PicoNodes/PicoNodes/pcb/motherboard/voltage regulation.org

Assuming LM317 regulator
target Vo: 3.3V
from datasheet: Vo = 1.25 * (1 + r / 240)

Where Vo = 3.3: r = 393.6 (~= 390Ω)

regulator:
https://www.kjell.com/se/sortiment/el-verktyg/elektronik/halvledare/spanningsregulatorer/luxorparts-spanningsregulator-variabel-lm317-5-pack-p90491
30kr for 5x

heat sink:
https://www.kjell.com/se/sortiment/el-verktyg/elektronik/elektromekanik/kylelement-peltier/luxorparts-kylflans-to-220-10-pack-p90668
40kr for 10x
