PicoNodes/PicoNodes/docs/architecture.docx

ää

Crystal

- Userinterface via browser(hemsida)
- Programmeringsinterface?
- Programmerare för MCU
- WiFi-kommunikation med server
- UARTx2
- Avkodare(FDTI)
- Kompilator
- Drivrutiner

WiFi

WiFi

Access Point(Plattform med WiFi)

Mobil Station(laptop, mobiltelefon)

Server

MOD

OD

MOD

MOD

MOD

MOD

MOD
