PicoNodes/PicoNodes/docs/server-diagram.jpg

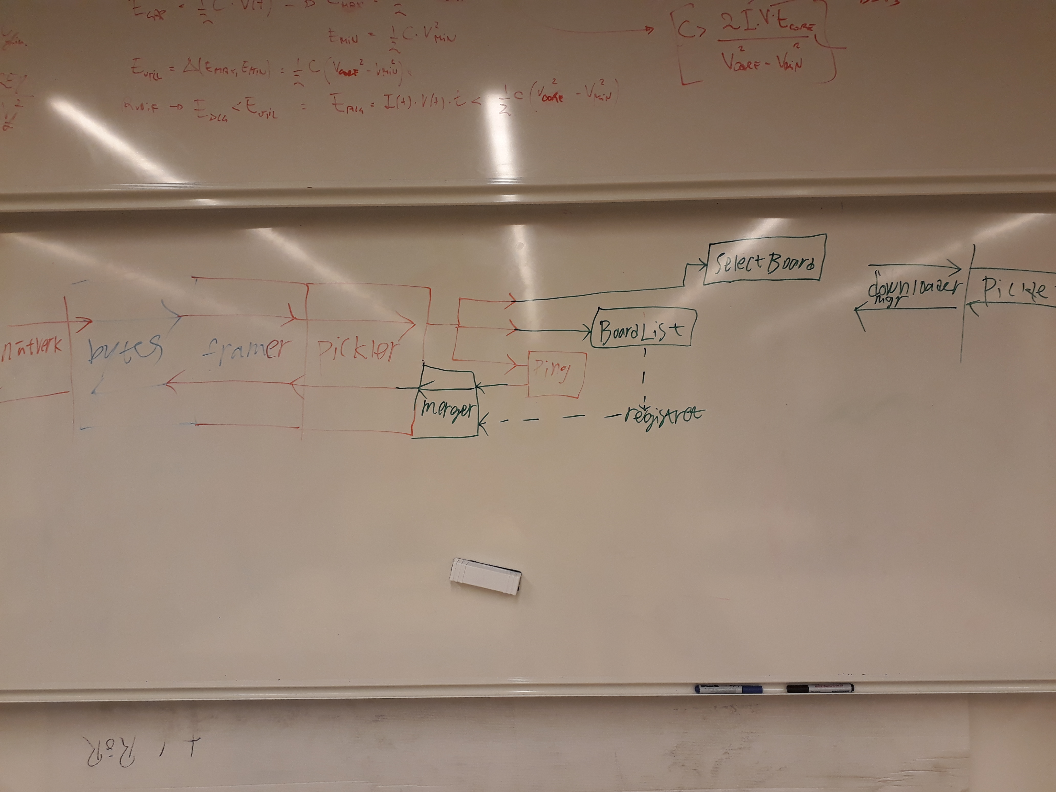
docs/server-diagram.jpg
