PicoNodes/PicoNodes/pcb/digit-node-breakout/digit-node.stl

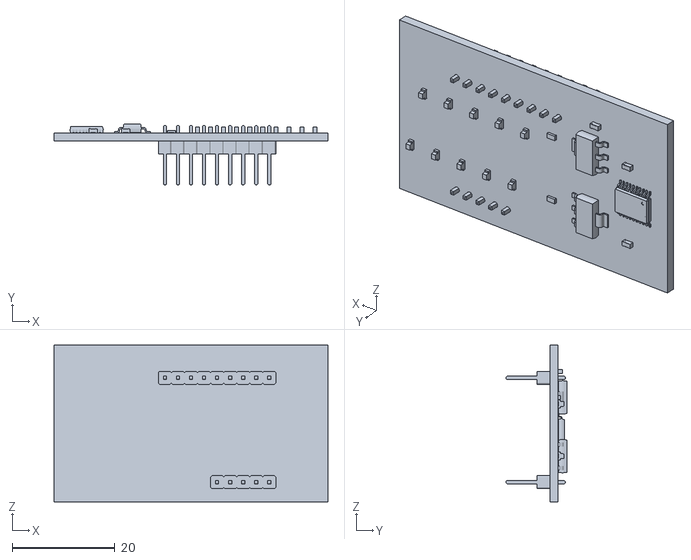
[picture p8: CAD file, 2018-05-01]
pcb/digit-node-breakout/digit-node.stl
53.3 x 11.8 x 30.5
