PicoNodes/PicoNodes/(threads)

Thread 9 (2018-03-21):

Design compute node PCB

Thereseken, 2018-03-21:

teozkr, 2018-04-19:
This was tracking the "production" PCBs, for use with the motherboard. The breakout board PCB was tracked by #18.

Closed 2018-05-08.

Thread 12 (2018-03-28):

Messy autoformatting - move to diffing?

teozkr, 2018-03-28:
Currently autoformatting tries to guess when you're "done" editing a line, and then replaces only that line. This is needed since CodeMirror moves the cursor to the end of the modified segment, if it was inside it.

It would be much nicer if we diffed the replacements, so that only the actually modified segments have to be moved around.

Alternately, consider moving to true [projectional editing]?

[projectional editing]: https://en.wikipedia.org/wiki/Structure_editor

Thread 15 (2018-03-30):

Clear up terminology

teozkr, 2018-03-30:
Currently we don't really have clear names for the different parts of the system. For example, so far I've referred to anything with a MCU in it as a "node", making the term fairly useless.

Therefore, I propose the following names:

* IDE: The graphical editor and debugger, code in `ide/picoide`
* Server: Serves the IDE, stores all data, and controls the Downloaders, code in `ide/picoserver`
* Downloader: Combined debugger and programmer, controls a single Node at a time
* Motherboard: Connects all the Nodes to each other, and supplies power and a common clock
* Node: Any component that is part of the target system, aside from the Motherboard
* NodePlug:tm:: The connector between a Node and the Motherboard
* Compute Node: A programmable Node running user-supplied code
* PicoASM: The language Compute Nodes are programmed in
* Peripheral Node: Any Node that is not a Compute Node
* PicoTalk: The protocol for communication between Nodes

# Why `Downloader`?

So far we've called these Programmers or Programmer Nodes, but both of these are confusing. As Mark mentioned, calling them `Programmer`s cheapens the act of /programming/ (which is what the users will be doing the rest of the time). They're also not Nodes, since they don't use the NodePlug, and don't use the Node<->Node protocol.

Other options:

* Controller
* Debugger

teozkr, 2018-04-10:
Moving this to `docs` since we agreed on it.

Closed 2018-04-10.

Thread 27 (2018-04-23):

Heartbeat for downloader<->server

teozkr, 2018-04-23:

teozkr, 2018-04-23:
This will require some refactoring, since the downloaders currently don't understand PicoStorm at all. We could either let it buffer messages completely, or just maintain bookkeeping to avoid injecting heartbeats in the middle of messages. Hmm...

Closed 2018-04-23.

Thread 33 (2018-04-30):

Numeric display

teozkr, 2018-04-30:

teozkr, 2018-04-30:
Working on a custom [Lixie](https://www.tindie.com/products/connornishijima/lixie-an-led-alternative-to-the-nixie-tube/) clone for this. It'll (sadly) have to be a single-digit display in order to fit into the Node form factor.

Thread 38 (2018-05-16):

ESP32 brownouts when 2 or more nodes are connected

teozkr, 2018-05-16:

teozkr, 2018-05-16:
Looks like we'll need our own voltage regulation circuitry.

The STM32F030F4 parts (and thus the nodes) can draw up to 120mA each:

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

The ESP requires a power supply capable of at least 500mA:

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

So in total we need a power supply capable of at least `500 + 9 * 120 = 1580` mA@3.3V.

The USB spec allows drawing up to 1.5A@5V, but only when negotiating via the Battery Charging spec or when using USB-C cables.

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

So I guess it looks like the most reasonable option is to switch to a barrel PSU... :/
