PicoNodes/PicoNodes/(list of files, drawings)

Other design files:
pcb/compute-node-breakout/more_flash_mod.dch
pcb/compute-node-breakout/more_flash_mod.dip
pcb/compute-node-breakout/proj_mod.dch
pcb/compute-node-breakout/test_mod.dip
