PicoNodes/PicoNodes/pcb/led-node/led-node.kicad_pcb

## KiCad design pcb/led-node/led-node.kicad_pcb (2018-05-29)

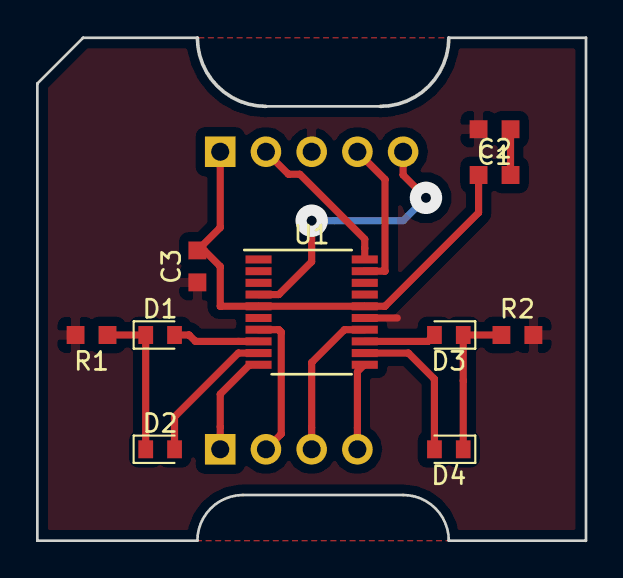
[picture p9: board led-node.kicad_pcb from above]

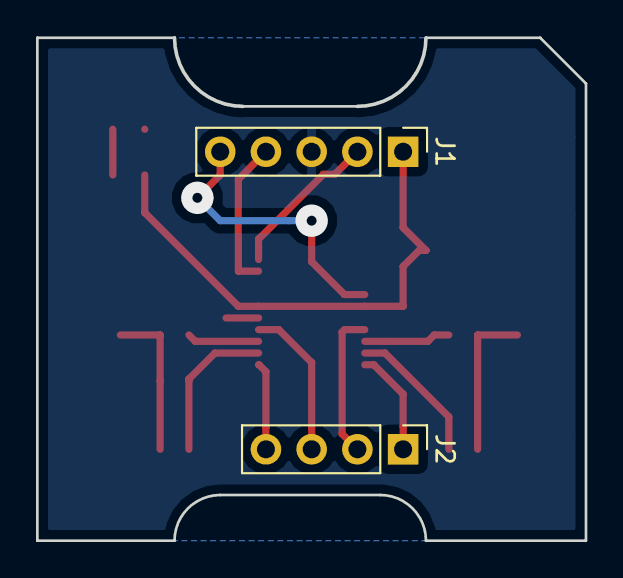
[picture p10: board led-node.kicad_pcb from below]

Board: 2 copper layers, 30.5 x 27.9 mm, 12 parts (2 on the bottom side), 16 nets.

Parts:
C1, C2: 100nF; C_0603_1608Metric_Pad0.99x1.00mm_HandSolder
C3: 10nF; C_0603_1608Metric_Pad0.99x1.00mm_HandSolder
D1: LED1; LED_0603_1608Metric_Pad0.82x1.00mm_HandSolder
D2: LED2; LED_0603_1608Metric_Pad0.82x1.00mm_HandSolder
D3: LED3; LED_0603_1608Metric_Pad0.82x1.00mm_HandSolder
D4: LED4; LED_0603_1608Metric_Pad0.82x1.00mm_HandSolder
J1: STM32_SWD; PinHeader_1x05_P2.54mm_Vertical
J2: PicoTalk; PinHeader_1x04_P2.54mm_Vertical
R1, R2: 100; R_0603_1608Metric_Pad0.99x1.00mm_HandSolder
U1: STM32F030F4Px; TSSOP-20_4.4x6.5mm_P0.65mm

Connections:
/Down: J2.1, U1.10
/Left: J2.2, U1.7
/Right: J2.4, U1.11
/SWCLK: J1.2, U1.20
/SWDIO: J1.4, U1.19
/Up: J2.3, U1.14
/nRST: J1.5, U1.4
GND: C1.2, C3.1, J1.3, R1.2, R2.2, U1.15
unnamed: C1.1, C2.2
unnamed: D1.1, D2.1, R1.1
unnamed: D1.2, U1.8
unnamed: D2.2, U1.9
unnamed: D3.1, D4.1, R2.1
unnamed: D3.2, U1.13
unnamed: D4.2, U1.12
VDD: C2.1, C3.2, J1.1, U1.5, U1.16
