PicoNodes/PicoNodes/pcb/motherboard/motherboard.kicad_pcb

## KiCad design pcb/motherboard/motherboard.kicad_pcb (2018-05-22)

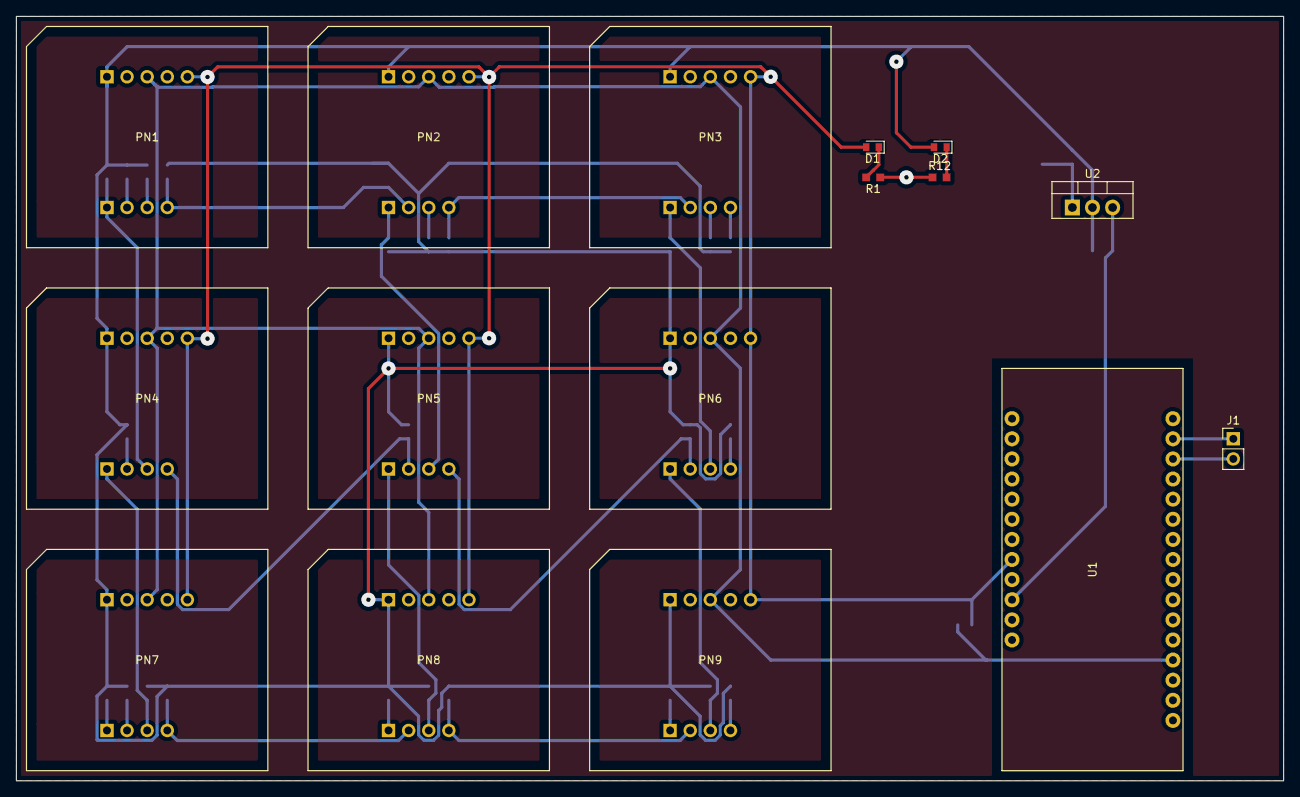
[picture p11: board motherboard.kicad_pcb from above]

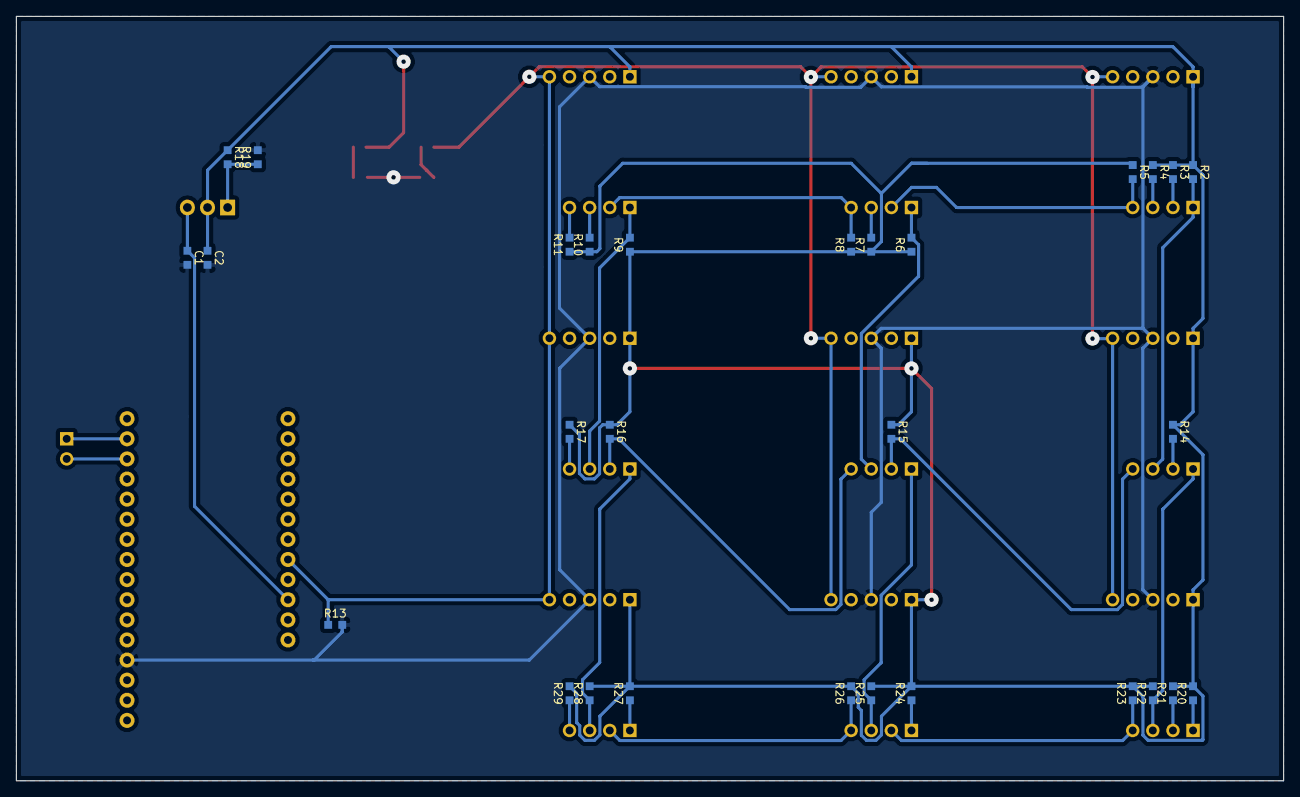
[picture p12: board motherboard.kicad_pcb from below]

Board: 2 copper layers, 160.0 x 96.5 mm, 45 parts (29 on the bottom side), 33 nets.

Parts:
C1: 0.1µF; C_0603_1608Metric_Pad0.99x1.00mm_HandSolder
C2: 1.0µF; C_0603_1608Metric_Pad0.99x1.00mm_HandSolder
D1: LED_Reset; LED_0603_1608Metric_Pad0.82x1.00mm_HandSolder
D2: LED_Vdd; LED_0603_1608Metric_Pad0.82x1.00mm_HandSolder
J1: UART; PinHeader_1x02_P2.54mm_Vertical
PN1, PN2, PN3, PN4, PN5, PN6, PN7, PN8, PN9: PicoNode-Socket-PH
R1, R12: 100; R_0603_1608Metric_Pad0.99x1.00mm_HandSolder
R2, R3, R4, R5, R6, R7, R8, R9, R10, R11, R14, R15, R16, R17, R20, R21, R22, R23, R24, R25, R26, R27, R28, R29: 4.7K; R_0603_1608Metric_Pad0.99x1.00mm_HandSolder
R13: 820; R_0603_1608Metric_Pad0.99x1.00mm_HandSolder
R18: 240; R_0603_1608Metric_Pad0.99x1.00mm_HandSolder
R19: 390; R_0603_1608Metric_Pad0.99x1.00mm_HandSolder
U1: Huzzah32; Adafruit_HUZZAH32
U2: LM317_3PinPackage; TO-220-3_Vertical

Connections:
/RX: J1.2, U1.26
/TX: J1.1, U1.27
/nReset: D1.2, PN1.5, PN2.5, PN3.5, PN4.5, PN5.5, PN6.5, PN7.5, PN8.5, PN9.5, R13.1, U1.5
GND: C1.2, C2.2, PN1.3, PN2.3, PN3.3, PN4.3, PN5.3, PN6.3, PN7.3, PN8.3, PN9.3, R1.1, R12.1, R13.2, R19.2, U1.16
unnamed: D1.1, R1.2
unnamed: D2.1, R12.2
unnamed: PN1.6, PN4.8, R2.2
unnamed: PN1.7, R3.2
unnamed: PN1.8, R4.2
unnamed: PN1.9, PN2.7, R5.2
unnamed: PN2.6, PN5.8, R6.2
unnamed: PN2.8, R7.2
unnamed: PN2.9, PN3.7, R8.2
unnamed: PN3.6, PN6.8, R9.2
unnamed: PN3.8, R10.2
unnamed: PN3.9, R11.2
unnamed: PN4.6, PN7.8, R22.1
unnamed: PN4.7, R14.2
unnamed: PN4.9, PN5.7, R15.2
unnamed: PN5.6, PN8.8, R25.1
unnamed: PN5.9, PN6.7, R16.2
unnamed: PN6.6, PN9.8, R28.1
unnamed: PN6.9, R17.2
unnamed: PN7.6, R20.1
unnamed: PN7.7, R21.1
unnamed: PN7.9, PN8.7, R23.1
unnamed: PN8.6, R24.1
unnamed: PN8.9, PN9.7, R26.1
unnamed: PN9.6, R27.1
unnamed: PN9.9, R29.1
unnamed: R18.2, R19.1, U2.1
VBUS: C1.1, U1.3, U2.3
VDD: C2.1, D2.2, PN1.1, PN2.1, PN3.1, PN4.1, PN5.1, PN6.1, PN7.1, PN8.1, PN9.1, R2.1, R3.1, R4.1, R5.1, R6.1, R7.1, R8.1, R9.1, R10.1, R11.1, R14.1, R15.1, R16.1, R17.1, R18.1, R20.2, R21.2, R22.2, R23.2, R24.2, R25.2, R26.2, R27.2, R28.2, R29.2, U2.2
