PicoNodes/PicoNodes/pcb/voltage-regulator-mezzanine/voltage-regulator-mezzanine.kicad_pcb

## KiCad design pcb/voltage-regulator-mezzanine/voltage-regulator-mezzanine.kicad_pcb (2018-05-19)

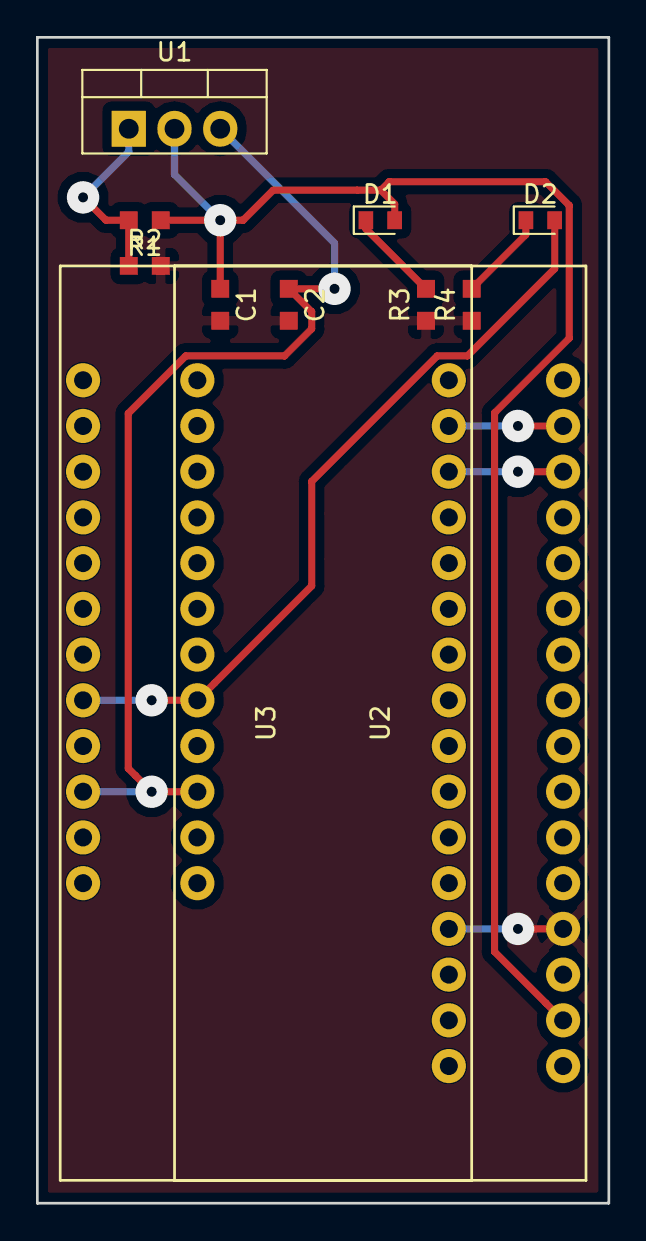
[picture p13: board voltage-regulator-mezzanine.kicad_pcb from above]

Board: 2 copper layers, 31.8 x 64.8 mm, 11 parts (0 on the bottom side), 9 nets.

Parts:
C1: 1.0µF; C_0603_1608Metric_Pad0.99x1.00mm_HandSolder
C2: 0.1µF; C_0603_1608Metric_Pad0.99x1.00mm_HandSolder
D1: LED_vdd; LED_0603_1608Metric_Pad0.82x1.00mm_HandSolder
D2: LED_nReset; LED_0603_1608Metric_Pad0.82x1.00mm_HandSolder
R1: 240; R_0603_1608Metric_Pad0.99x1.00mm_HandSolder
R2: 390; R_0603_1608Metric_Pad0.99x1.00mm_HandSolder
R3, R4: 100; R_0603_1608Metric_Pad0.99x1.00mm_HandSolder
U1: LM317_3PinPackage; TO-220-3_Vertical
U2: Huzzah32_fake; Adafruit_HUZZAH32
U3: Huzzah32_real; Adafruit_HUZZAH32

Connections:
/Adj: R1.2, R2.1, U1.1
GND: C1.2, C2.2, R2.2, R3.1, R4.1, U2.16, U3.16
unnamed: D1.1, R3.2
unnamed: D2.1, R4.2
unnamed: D2.2, U2.5, U3.5
unnamed: U2.26, U3.26
unnamed: U2.27, U3.27
VBUS: C2.1, U1.3, U2.3, U3.3
VDD: C1.1, D1.2, R1.1, U1.2, U2.14
