PicoNodes/PicoNodes/pcb/debug-mezzanine/debug-mezzanine.kicad_pcb

## KiCad design pcb/debug-mezzanine/debug-mezzanine.kicad_pcb (2018-05-15)

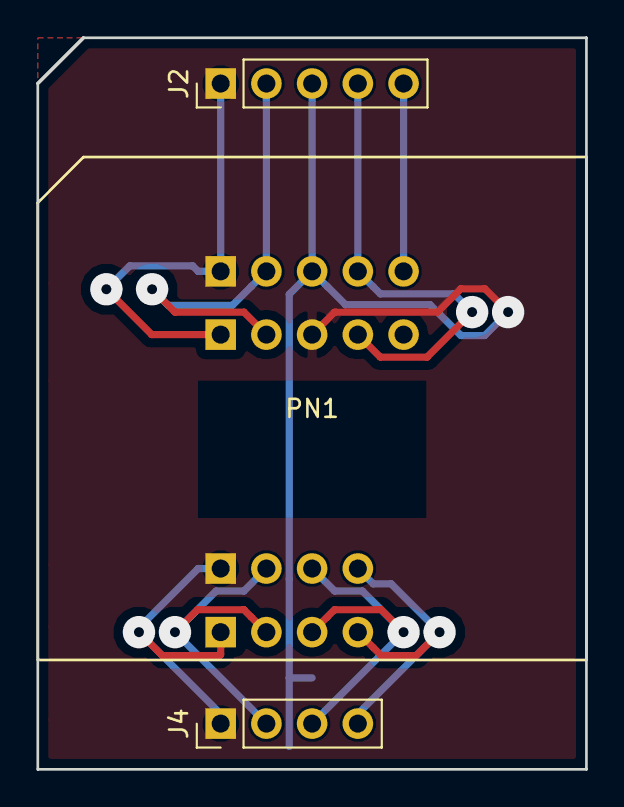
[picture p14: board debug-mezzanine.kicad_pcb from above]

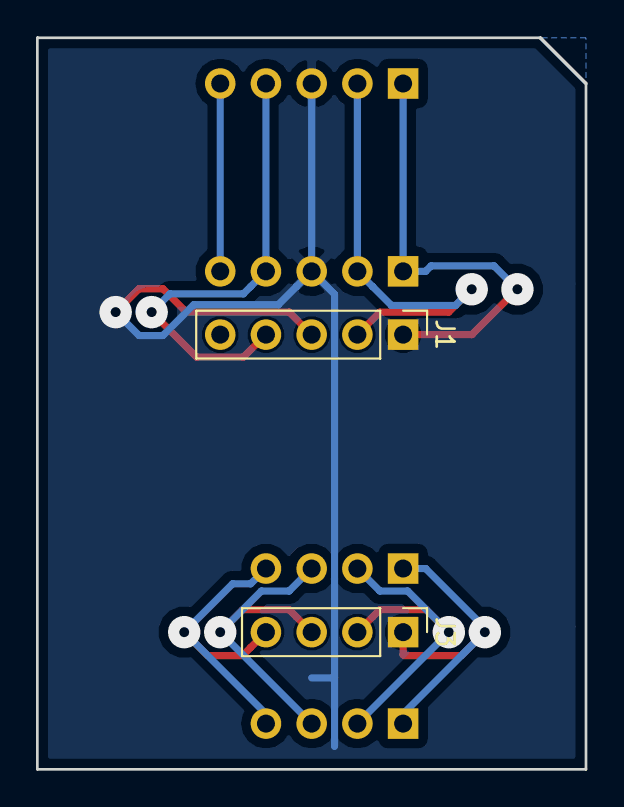
[picture p15: board debug-mezzanine.kicad_pcb from below]

Board: 2 copper layers, 30.5 x 40.6 mm, 5 parts (2 on the bottom side), 9 nets.

Parts:
J1, J2: STM32_SWD; PinHeader_1x05_P2.54mm_Vertical
J3, J4: PicoTalk; PinHeader_1x04_P2.54mm_Vertical
PN1: PicoNode-Socket-PH

Connections:
GND: J1.3, J2.3, PN1.3
unnamed: J1.2, J2.2, PN1.2
unnamed: J1.4, J2.4, PN1.4
unnamed: J2.5, PN1.5
unnamed: J3.1, J4.1, PN1.6
unnamed: J3.2, J4.2, PN1.7
unnamed: J3.3, J4.3, PN1.8
unnamed: J3.4, J4.4, PN1.9
VDD: J1.1, J2.1, PN1.1
