PicoNodes/PicoNodes/pcb/digit-node-breakout/digit-node.kicad_pcb

## KiCad design pcb/digit-node-breakout/digit-node.kicad_pcb (2018-05-03)

Schematic: digit-node.sch

Parts:
C1, C2, C3: CP; C_0603_1608Metric
J1: Conn_01x09_Male; PinHeader_1x09_P2.54mm_Vertical
J2: STM32_SWD; PinHeader_1x05_P2.54mm_Vertical
Q1: BC847BS; SOT-363_SC-70-6
R1, R2: 100; R_0603_1608Metric
U1: STM32F030F4Px; TSSOP-20_4.4x6.5mm_P0.65mm

Connections:
/led_matrix/gnd_even: R2.1; also elsewhere on the board
/led_matrix/gnd_odd: R1.1; also elsewhere on the board
/led_matrix/led_01: U1.14; also elsewhere on the board
/led_matrix/led_23: U1.8; also elsewhere on the board
/led_matrix/led_45: U1.9; also elsewhere on the board
/led_matrix/led_67: U1.12; also elsewhere on the board
/led_matrix/led_89: U1.13; also elsewhere on the board
GND: C1.2, C3.2, J1.1, J2.3, Q1.1 (E1), Q1.4 (E2), U1.15
unnamed: C2.2, C3.1
unnamed: J1.4, U1.6
unnamed: J1.5, U1.3
unnamed: J1.6, U1.2
unnamed: J1.7, U1.7
unnamed: J1.8, U1.17
unnamed: J1.9, U1.18
unnamed: J2.2, U1.20
unnamed: J2.4, U1.19
unnamed: J2.5, U1.4
unnamed: Q1.2 (B1), U1.10
unnamed: Q1.3 (C2), R2.2
unnamed: Q1.5 (B2), U1.11
unnamed: Q1.6 (C1), R1.2
VDD: C1.1, J1.2, J2.1, U1.16
VDDA: C2.1, J1.3, U1.5

Schematic: led_matrix.sch

Parts:
D1: LED_0; LED_0603_1608Metric
D2: LED_1; LED_0603_1608Metric
D3: LED_2; LED_0603_1608Metric
D4: LED_3; LED_0603_1608Metric
D5: LED_4; LED_0603_1608Metric
D6: LED_5; LED_0603_1608Metric
D7: LED_6; LED_0603_1608Metric
D8: LED_7; LED_0603_1608Metric
D9: LED_8; LED_0603_1608Metric
D10: LED_9; LED_0603_1608Metric

Connections:
/led_matrix/gnd_even: D2.1, D4.1, D6.1, D8.1, D10.1; also elsewhere on the board
/led_matrix/gnd_odd: D1.1, D3.1, D5.1, D7.1, D9.1; also elsewhere on the board
/led_matrix/led_01: D1.2, D2.2; also elsewhere on the board
/led_matrix/led_23: D3.2, D4.2; also elsewhere on the board
/led_matrix/led_45: D5.2, D6.2; also elsewhere on the board
/led_matrix/led_67: D7.2, D8.2; also elsewhere on the board
/led_matrix/led_89: D9.2, D10.2; also elsewhere on the board

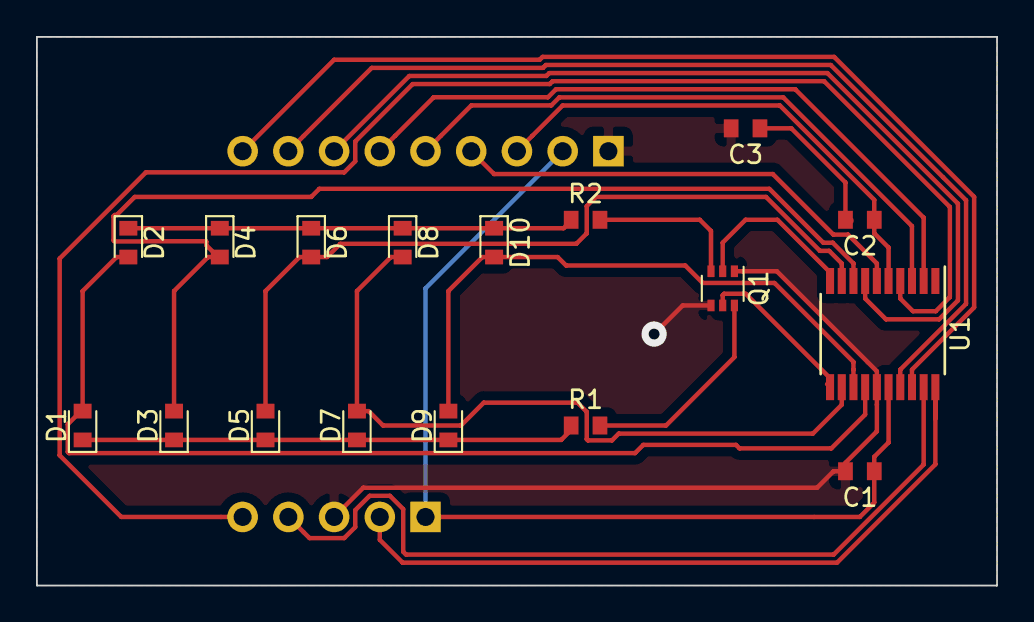
[picture p16: board digit-node.kicad_pcb from above]

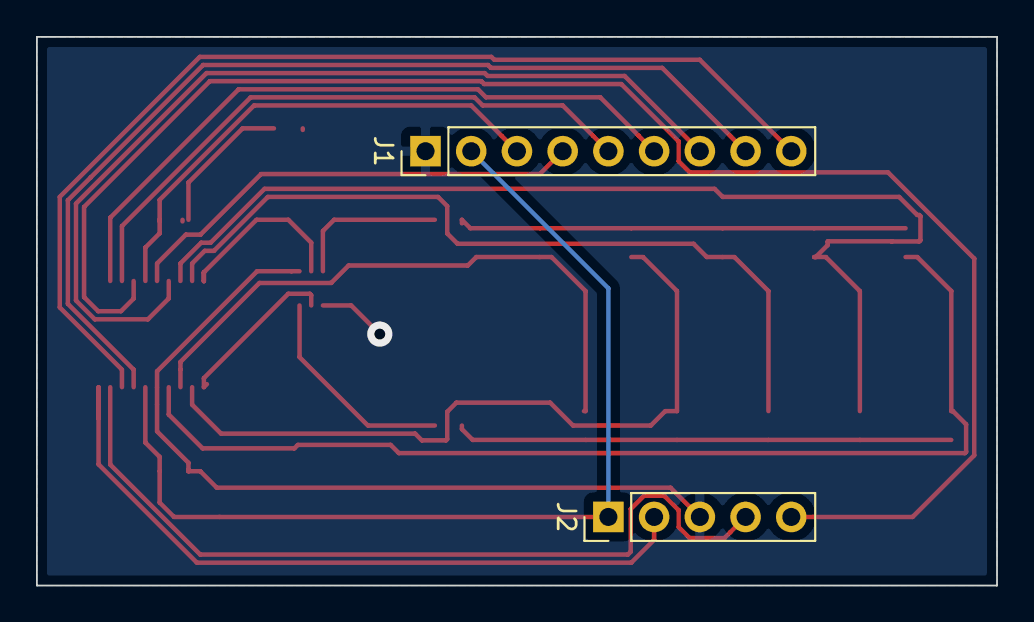
[picture p17: board digit-node.kicad_pcb from below]

Board: 2 copper layers, 53.3 x 30.5 mm, 19 parts (2 on the bottom side), 24 nets.
