PicoNodes/PicoNodes/firmware/node-compute/opendrainy-rtfm/src/main.rs

// -*- mode: rust; flycheck-rust-check-tests: nil; -*-

#![feature(used, proc_macro)]
#![no_std]

extern crate cortex_m;
extern crate cortex_m_rt;
extern crate cortex_m_rtfm as rtfm;
extern crate cortex_m_semihosting;
extern crate panic_semihosting;
extern crate stm32f0x0_hal;
extern crate embedded_hal;
extern crate picostorm;

#[macro_use]
extern crate nb;

use core::fmt::Write;
use cortex_m_semihosting::hio;

use rtfm::{app, Threshold};
#[allow(unused)]
use cortex_m::asm;

use stm32f0x0_hal::prelude::*;
use stm32f0x0_hal::stm32f0x0;
use stm32f0x0_hal::serial::{Rx, Tx, Serial, Event as SerialEvent};
use stm32f0x0_hal::gpio::{Output, OpenDrain, gpioa::PA4};
use stm32f0x0_hal::timer::{Timer, Event as TimerEvent};

fn echo_incoming(_t: &mut Threshold, r: USART1::Resources) {
    let mut rx = r.SERIAL1_RX;

    let cmd = picostorm::Command::read(&mut *rx).unwrap();

    let mut out = hio::hstdout().unwrap();
    writeln!(out, "{:?}", cmd).unwrap();
}

fn loopback(_t: &mut Threshold, r: USART1::Resources) {
    let mut rx = r.SERIAL1_RX;
    let mut tx = r.SERIAL1_TX;

    block!(tx.write(rx.read().unwrap())).unwrap();
}

fn blink(_t: &mut Threshold, r: TIM3::Resources) {
    let mut timer = r.BLINKY_TIMER;
    let mut state = r.BLINKY_STATE;
    let mut pin = r.BLINKY_PIN;

    timer.wait().unwrap();

    *state = !*state;
    if *state {
        pin.set_high();
    } else {
        pin.set_low();
    }
}

fn init(p: init::Peripherals, _r: init::Resources) -> init::LateResources {
    let mut rcc = p.device.RCC.constrain();
    let mut flash = p.device.FLASH.constrain();
    let clocks = rcc.cfgr.freeze(&mut flash.acr);
    let mut gpioa = p.device.GPIOA.split(&mut rcc.ahb);

    let pa2 = gpioa.pa2.into_af1(&mut gpioa.moder, &mut gpioa.afrl);
    let pa3 = gpioa.pa3.into_af1(&mut gpioa.moder, &mut gpioa.afrl);
    let pa4 = gpioa.pa4.into_open_drain_output(&mut gpioa.moder, &mut gpioa.otyper);

    let mut tim3 = Timer::tim3(p.device.TIM3, 1.hz(), clocks, &mut rcc.apb1);
    tim3.listen(TimerEvent::TimeOut);

    let usart1 = p.device.USART1;
    let mut serial = Serial::usart1(usart1, (pa2, pa3), 115_200.bps(), clocks, &mut rcc.apb2);
    serial.listen(SerialEvent::Rxne);
    let (tx, rx) = serial.split();

    init::LateResources {
        SERIAL1_RX: rx,
        SERIAL1_TX: tx,
        BLINKY_TIMER: tim3,
        BLINKY_PIN: pa4,
    }
}

fn idle() -> ! {
    loop {
        rtfm::wfi();
    }
}

app! {
    device: stm32f0x0,
    resources: {
        static SERIAL1_RX: Rx<stm32f0x0::USART1>;
        static SERIAL1_TX: Tx<stm32f0x0::USART1>;

        static BLINKY_TIMER: Timer<stm32f0x0::TIM3>;
        static BLINKY_STATE: bool = false;
        static BLINKY_PIN: PA4<Output<OpenDrain>>;
    },
    tasks: {
        USART1: {
            path: echo_incoming,
            resources: [SERIAL1_RX, SERIAL1_TX],
            priority: 2,
        },

        TIM3: {
            path: blink,
            resources: [BLINKY_TIMER, BLINKY_STATE, BLINKY_PIN],
            priority: 1,
        }
    }
}
