PicoNodes/PicoNodes/(commit log)

2018-03-20 Added design notes and PCB sketch
2018-03-20 Adding guide lines for external oscillator design and data sheet for the microcontroller STM32F030F4P6
    Adding guide lines for external oscillator design and data sheet for the microcontroller STM32F030F4P6
2018-03-20 First prototype of assembler
2018-03-20 Allow empty lines, comments prototype
2018-03-20 Module files
    PCB files for module, patterns and component
    [proj_mod.dch]
2018-03-21 greberfiler
    Alla gerberfiler som kan tänkas behövas för att fräsa PCB
    [proj_mod.dch, test_mod.dip]
2018-03-26 PCB and method in report
    beginning of method in the report
    [test_mod.dip]
2018-03-29 IDE: Started integrating IDEClient
    Currently broken because Sink.actorRefWithAck causes linking errors,
    investigating alternative solutions
2018-03-29 IDE: Board picker UI
2018-03-30 Connected board picker to NodeRegistry
2018-03-31 Client-side board selection
2018-04-04 module and project updates
    module and report updates
    [project_plan.xlsx]
2018-04-05 Swappable flow adapter
2018-04-05 Migrated to a separate IDECommandHandler stage
2018-04-05 More lenses
2018-04-11 testcodes and dic
    for mcu questionformular
    [test_mod.dip]
2018-04-11 LED blinker for F0 MCU
2018-04-11 Reorganized firmware to separate different parts
    Fixes #21
    [blinky.rs, main.rs]
2018-04-13 Moved stm32f0x0 to https://github.com/PicoNodes/stm32f0x0
2018-04-13 Renamed BoardPicker to DownloaderPicker
2018-04-13 Imported ESP32 hello world
2018-04-16 Diode-React has now released a ScalaJS-React 1.2 build, so we no longer need to rebuild it ourselves
2018-04-16 Couple error handling for DownloaderServer
2018-04-17 Added reconnect button
2018-04-17 Implemented the other instructions in the assembler
2018-04-17 Styling for assembler errors
2018-04-17 netclient on ESP32 now sorta kinda maybe works
    [partitions.csv]
2018-04-18 Downloader can now communicate over UART!
2018-04-19 Starting write to pin. Compiling
2018-04-20 Finnished writing value to pin func
2018-04-23 Fixed opendrainy-rtfm not firing USART interrupts
    [main.rs]
2018-04-23 Print received PicoStorm commands
2018-04-24 Finnished reading pin. Compiles
2018-04-30 Fixed flash memory writes
    Fixes #29
    [main.rs]
2018-04-30 Moved breakout board to separate subfolder
    [proj_mod.dch, test_mod.dip]
2018-04-30 Added Digit Node schematic draft
    [digit-module.sch, led_matrix.sch]
2018-05-01 Digit display enclosure and PCB draft routing
    However, still need to verify that everything fits together before
    milling/printing
    Exact transistor/LED values also need to be confirmed...
    [digit-module.kicad_pcb, digit-module.sch, enclosure.scad]
2018-05-01 Renamed digit-module for consistency
    [digit-module.kicad_pcb, digit-node.kicad_pcb, digit-node.sch, enclosure.scad, led_matrix.sch]
2018-05-01 More digit PCB cleanup
    [digit-node.kicad_pcb, digit-node.sch]
2018-05-01 Digit PCB is now 100% via-free!
    [digit-node.kicad_pcb, digit-node.sch]
2018-05-01 Moved the pin headers closer to each other
    [digit-node.kicad_pcb, digit-node.sch]
2018-05-01 Even more compact!
    [digit-node.kicad_pcb]
2018-05-01 Oops.. missed a stale track screwing with things
    [digit-node.kicad_pcb]
2018-05-01 Board cleanup
    [digit-node.kicad_pcb]
2018-05-01 Ground planes
    [digit-node.kicad_pcb]
2018-05-01 Board outline
    [digit-node.kicad_pcb]
2018-05-01 A (hopefully) working enclosure (after many ifs and buts)
    [digit-node.kicad_pcb, digit-node.stl, enclosure.scad]
2018-05-01 Documented how to get STL files out of KiCad
2018-05-02 PCB cavity for enclosure
    [enclosure.scad]
2018-05-02 Enclosure cleanup
    [enclosure.scad]
2018-05-02 Use a transistor array instead of two discrete transistors
    [digit-node.kicad_pcb, digit-node.sch]
2018-05-02 module for more flash pcb. Not tested
    [more_flash_mod.dch, more_flash_mod.dip]
2018-05-03 small updates to the pcb more_flash_mod
    [more_flash_mod.dch, proj_mod.dch]
2018-05-03 Some comments on the pico-commpute srcfile
2018-05-03 Adapted PCB for Mentorspace mill design rules
    [digit-node.kicad_pcb]
2018-05-04 Finnished picotalk and started node communication task and path
    [more_flash_mod.dip]
2018-05-07 Started working on a the node motherboard...
    [compute-node.kicad_pcb, compute-node.sch, motherboard.kicad_pcb, motherboard.sch]
2018-05-07 Adopted compute node PCB to use pin headers
    Since we currently don't have any 1mm PCB stock to use
    [compute-node.kicad_pcb, compute-node.sch]
2018-05-07 LED and button node PCBs
    [button-node.kicad_pcb, button-node.sch, led-node.kicad_pcb, led-node.sch]
2018-05-07 testing communication. It does not work
    [main.rs]
2018-05-07 Try for transmit and recieve. This do not work
    [main.rs]
2018-05-08 Fixed PicoTalk timing issues
    [main.rs]
2018-05-08 Motherboard PCB
    [button-node.kicad_pcb, compute-node.kicad_pcb, compute-node.sch, led-node.kicad_pcb, motherboard.kicad_pcb, motherboard.sch]
2018-05-08 Pin orientation
    [button-node.kicad_pcb, compute-node.kicad_pcb, led-node.kicad_pcb, led-node.sch, motherboard.kicad_pcb]
2018-05-10 datasheet for the piconode-led
    [_saved_led-node.sch]
2018-05-11 User manual for the piconode-switch
2018-05-11 Prepared piconode-led and -switch for the "real" node boards
    [_saved_led-node.sch]
2018-05-14 Made PicoNode-LED resync the PicoTalk clock at the beginning of each message
    This allows stable communication at 10kHz
2018-05-14 Debug mezzanine PCB
    [debug-mezzanine.kicad_pcb, debug-mezzanine.sch]
2018-05-14 user example
    Doc procoded with example for the user to program one piconode and use
    it with the lednode and the switchnode
    [_saved_led-node.sch]
2018-05-15 Fixed some pins not being isolated properly on the mezzanine board
    [debug-mezzanine.kicad_pcb, led-node.kicad_pcb]
2018-05-15 Use the ground plane, Luke!
    [debug-mezzanine.kicad_pcb]
2018-05-15 Fixed a race condition in LED<->Switch communication
    [main.rs]
2018-05-16 Suggest saving before switching file
2018-05-16 Reformat the current line on blur
2018-05-17 Bring our own voltage regulator instead of using the Huzzah32's built-in
    [motherboard.kicad_pcb, motherboard.sch]
2018-05-17 Via optimization
    [motherboard.kicad_pcb]
2018-05-17 Fill update
    [motherboard.kicad_pcb]
2018-05-17 Track cleanup
    [motherboard.kicad_pcb]
2018-05-17 Nicer motherboard markings
    [motherboard.kicad_pcb]
2018-05-17 We definitely need a heat sink...
2018-05-18 Added status LEDs to motherboard
    [motherboard.kicad_pcb, motherboard.sch]
2018-05-18 Make the DRC happy
    [motherboard.kicad_pcb]
2018-05-18 Moved LED node text
    [led-node.kicad_pcb]
2018-05-18 Voltage regulator mezzanine
    Got to bodge it since we don't have the PCB area to make another new motherboard
    Vbus is still forwarded, so it will still work (although have no real use) with
    the new motherboard
    [voltage-regulator-mezzanine.kicad_pcb, voltage-regulator-mezzanine.sch]
2018-05-21 Added label to the current file name
2018-05-21 Only one LED colour
2018-05-22 Various desperate troubleshooting
    [motherboard.kicad_pcb, motherboard.sch]
2018-05-22 PN-switch spellcheck
2018-05-29 Discuss the node design
    [led-node.kicad_pcb, led-node.sch]
2018-06-01 Power usage documentation
2018-06-01 Dropped power usage calculations
